benvvalk/split-steno-kb/routed.kicad_pcb

## KiCad design routed.kicad_pcb (2024-08-04)

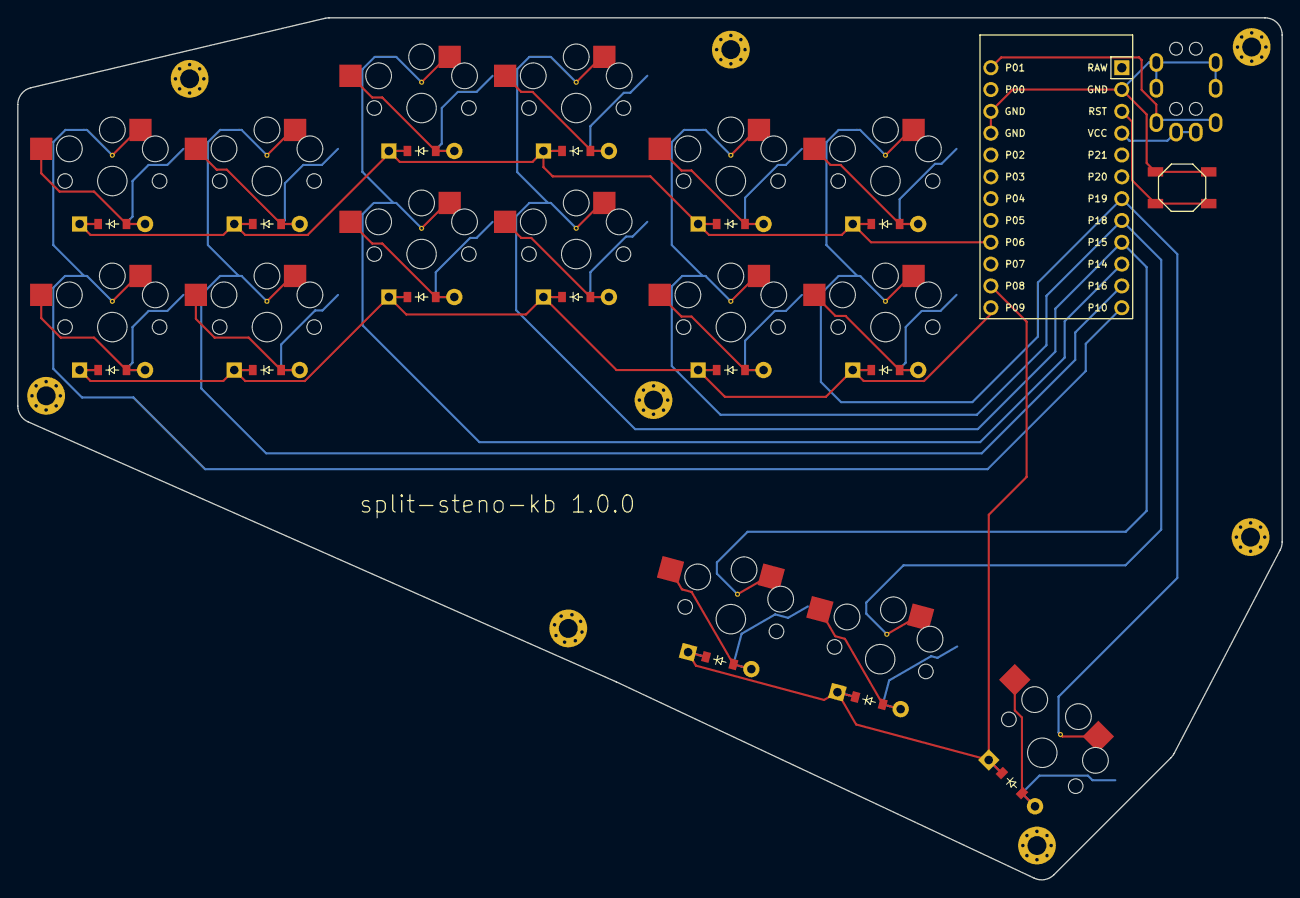
[picture p1: board routed.kicad_pcb from above]

Board: 2 copper layers, 147.2 x 100.3 mm, 41 parts (0 on the bottom side), 28 nets.

Parts:
B1: SW_TACT_ALPS_SKQGABE010
D1, D2, D3, D4, D5, D6, D7, D8, D9, D10, D11, D12, D13, D14, D15: ComboDiode
MCU1: ProMicro
S1, S2, S3, S4, S5, S6, S7, S8, S9, S10, S11, S12, S13, S14, S15: PG1350
TRRS1: TRRS-PJ-320A-dual
_16, _17, _18, _19, _20, _21, _22, _23: MountingHole_2.2mm_M2_Pad_Via

Connections:
GND: B1.1, MCU1.2, MCU1.15, MCU1.16, TRRS1.3, TRRS1.4
P1: MCU1.13, TRRS1.2
P6: D2.1, D4.1, D6.1, D8.1, D10.1, D12.1, MCU1.21
P8: D13.1, D14.1, D15.1, MCU1.23
P9: D1.1, D3.1, D5.1, D7.1, D9.1, D11.1, MCU1.24
P10: MCU1.12, S1.1, S2.1
P14: MCU1.10, S5.1, S6.1
P15: MCU1.9, S7.1, S8.1, S13.1
P16: MCU1.11, S3.1, S4.1
P18: MCU1.8, S9.1, S10.1, S14.1
P19: MCU1.7, S11.1, S12.1, S15.1
RST: B1.2, MCU1.3
VCC: MCU1.4, TRRS1.1
index_bottom: D9.2, S9.2
index_top: D10.2, S10.2
inner_bottom: D11.2, S11.2
inner_row0: D15.2, S15.2
inner_top: D12.2, S12.2
left_row0: D13.2, S13.2
middle_bottom: D7.2, S7.2
middle_top: D8.2, S8.2
outer_bottom: D1.2, S1.2
outer_top: D2.2, S2.2
pinky_bottom: D3.2, S3.2
pinky_top: D4.2, S4.2
right_row0: D14.2, S14.2
ring_bottom: D5.2, S5.2
ring_top: D6.2, S6.2
