benvvalk/split-steno-kb/(commit log)

2024-07-08 ergogen.yaml: add outlines ("pcb", "keys", "debug") [feat]
2024-07-27 ergogen.yaml: add pcb definition, add promicro and trrs components [feat]
2024-07-27 ergogen.yaml: add reset button [feat]
2024-07-28 import: footprints/mountinghole.js from MvEerd/ergogen bca205f [import]
    Import the M2 mounting hole footprint from the `MvEeerd/ergogen`
    GitHub repo, from commit bca205f.
    I will need M2 mounting holes because, for the keyboard "case", I'm
    planning to vertically stack two identical PCBs joined by M2
    standoffs. The bottom PCB will have no components soldered onto it,
    and its only purpose will be to provide a flat surface for the
    keyboard to rest on. It is not safe/sturdy to rest the top PCB
    directly on the desk surface, because it will have various components
    soldered to the back side (e.g. choc hotswap sockets, diodes).
2024-08-03 config.yaml: add mounting holes [feat]
2024-08-04 config.yaml: add vias to connect hotswap pads [feat]
    Add per-key vias to connect choc hotswap SMD pads on opposite sides of
    the board.
    This is a reversible PCB, and using vias saves me the additional
    work/complexity of routing the matrix columns on both sides of the
    board.
2024-08-04 import: routed.kicad_* (manually routed PCB) [import]
    Commit the .kicad_pcb and related files after manually adding the
    copper traces to the PCB in KiCad (i.e. the "routing" step).
    Note 1: Ergogen does not perform the routing step because it's too
    hard to automate. Therefore I had to do the routing manually in
    KiCad. That also means that if I ever make further changes to
    `ergogen.yaml` and regenerate, I will need to redo the routing!
    Note 2: This is my first time doing routing in KiCad and it took about
    2 hours. Next time, I expect I could complete it under an hour.
    [routed.kicad_pcb]
2024-08-04 routed.kicad_pcb: fix trrs connections, unconnected diodes [bugfix]
    Connected serial data pin P1 of Arduino to pin 2 of TRRS jack, rather
    than pin 3 of TRRS jack. Using pin 2 for the serial data will allow
    the use of both TRS and TRRS cables, whereas the former use of pin 3
    would only work with TRRS cables.
    Connect some diode pads that I forgot to connect (thanks, Design Rules
    Checker).
    [routed.kicad_pcb]
2024-08-04 board setup: set "solder mask clearance" to 0 [config]
    In the File -> Board Setup dialog, change "solder mask clearance" from
    0.05 -> 0.
    I'm doing this because there was a warning in the File -> Fabrication
    Outputs -> Gerbers dialog that told me I should do that.
    [routed.kicad_pcb]
2024-08-04 pcb: add "split-steno-kb 1.0.0" to silkscreen layer [feat]
    Add a version number to the PCB, so I won't get confused if I end up
    making multiple versions of the board.
    [routed.kicad_pcb]
2024-08-10 import: gerbers.zip [import]
    I generated gerber and drill files from `routed.pcb` using File ->
    Production Outputs -> Gerbers (.gbr)... in KiCad, then zipped them up
    into gerbers.zip.
